kingbear79/VacUBear/pcb/3D_PCB1_2026-03-05.png

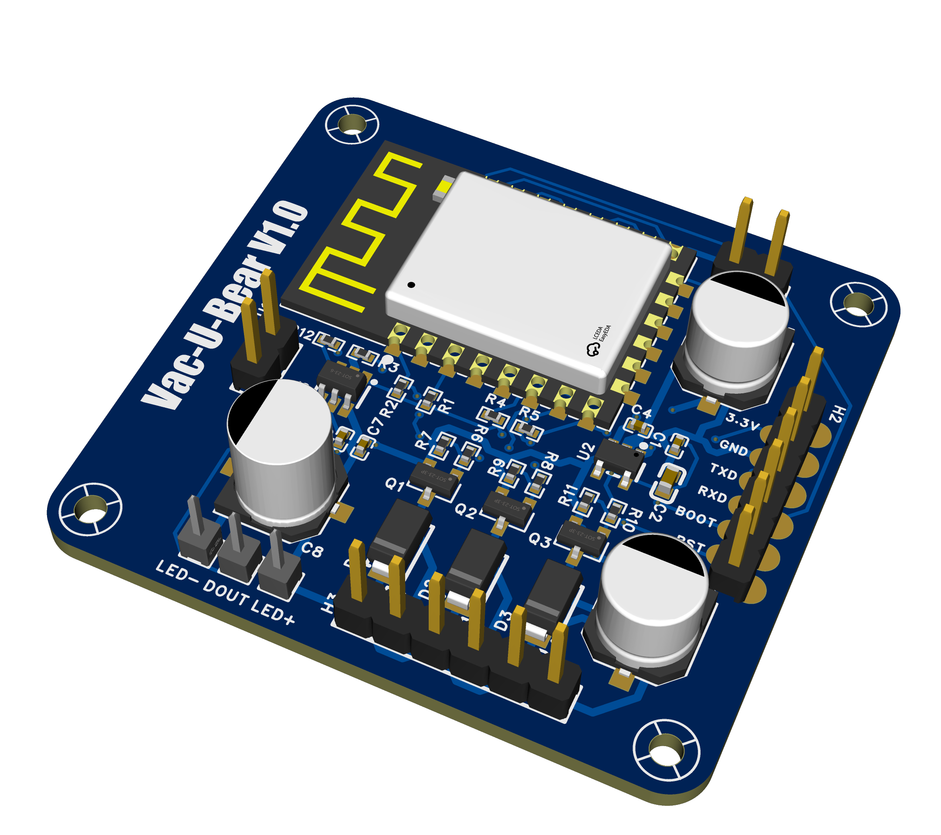
pcb/3D_PCB1_2026-03-05.png
