kingbear79/VacUBear/pcb/BOM_Board1_PCB1_2026-03-05.xlsx

No. | Quantity | Comment | Designator | Footprint | Value | Manufacturer Part | Manufacturer | Supplier Part | Supplier
1 | 4 | 100nF | C1,C4,C6,C7 | C0402 | 100nF | CL05B104KB54PNC | SAMSUNG(三星) | C307331 | LCSC
2 | 1 | 10uF | C2 | C0603 | 10uF | CL10A106MQ8NNNC | SAMSUNG(三星) | C1691 | LCSC
3 | 2 | 470uF | C3,C5 | CAP-SMD_BD6.3-L6.6-W6.6-LS7.6-RD | 470uF | RVT1C471M0607 | ROQANG(容强) | C2977552 | LCSC
4 | 1 | 100uF | C8 | CAP-SMD_BD6.3-L6.6-W6.6-LS7.2-FD | 100uF | RVT100UF16V67RV0016 | KNSCHA(科尼盛) | C2887276 | LCSC
5 | 3 | SS14 | D1,D2,D3 | SMA_L4.2-W2.6-LS5.0-RD_1 |  | SS14 | MDD(辰达半导体) | C2480 | LCSC
6 | 1 | POWER | H1 | HDR-TH_2P-P2.54-V-M-1
7 | 1 | PROG | H2 | PogoProgPad
8 | 1 | PUMPS | H3 | HDR-TH_6P-P2.54-V-M-1
9 | 1 | BTN | H4 | HDR-TH_2P-P2.54-V-M-1
10 | 1 | LED+ | H5 | HDR-TH_1P-V-M_XKB_X4611WV-01I-C28D40
11 | 1 | DOUT | H6 | HDR-TH_1P-V-M_XKB_X4611WV-01I-C28D40
12 | 1 | LED- | H7 | HDR-TH_1P-V-M_XKB_X4611WV-01I-C28D40
13 | 3 | AO3400A | Q1,Q2,Q3 | SOT-23-3_L2.9-W1.3-P1.90-LS2.4-BR |  | AO3400A | HUASHUO(华朔) | C700953 | LCSC
14 | 5 | 10kΩ | R1,R2,R3,R4,R5 | R0402 | 10kΩ | RC0402JR-0710KL | YAGEO(国巨) | C60489 | LCSC
15 | 3 | 100Ω | R6,R8,R10 | R0402 | 100Ω | FRC0402F1000TS | FOJAN(富捷) | C2906860 | LCSC
16 | 3 | 100kΩ | R7,R9,R11 | R0402 | 100kΩ | RC0402FR-07100KL | YAGEO(国巨) | C60491 | LCSC
17 | 1 | 33Ω | R12 | R0402 | 33Ω | FRC0402F33R0TS | FOJAN(富捷) | C2906868 | LCSC
18 | 1 | 330Ω | R13 | R0402 | 330Ω | FRC0402F3300TS | FOJAN(富捷) | C2930002 | LCSC
19 | 4 | Screw-Hole-M2 | SCREW1,SCREW2,SCREW3,SCREW4 | Screw-Hole-M2
20 | 1 | 2.4GHz | U1 | WIRELM-SMD_ESP-12F | 2.4GHz | ESP-12F | DOIT(四博智联) | C19949064 | LCSC
21 | 1 | TPAP2112K-3.3TRG1 | U2 | SOT-23-5_L2.9-W1.6-P0.95-LS2.8-BR |  | TPAP2112K-3.3TRG1 | TECH PUBLIC(台舟) | C3021085 | LCSC
22 | 1 | SN74LVC1T45DBVT | U3 | SOT-23-6_L2.9-W1.6-P0.95-LS2.8-BR |  | SN74LVC1T45DBVT | TI(德州仪器) | C116653 | LCSC
