kingbear79/VacUBear/pcb/SCH_Schematic1_2026-03-05.pdf

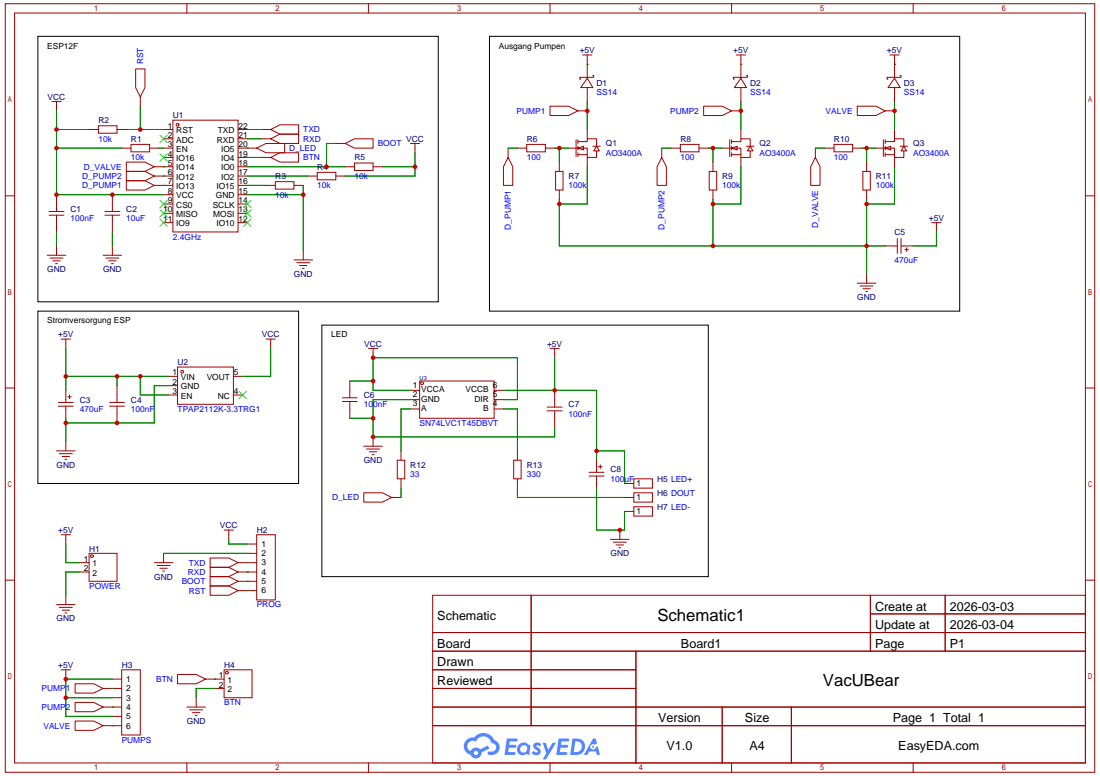
[picture p2: page 1]

Schematic | Schematic1 | Create at | 2026-03-03

Update at | 2026-03-04

Board | Board1 | Page | P1
Drawn | | VacUBear
Reviewed

Version | Size | Page 1 Total 1
V1.0 | A4 | EasyEDA.com
