kingbear79/VacUBear/pcb/PCB_PCB1_2026-03-05.pdf

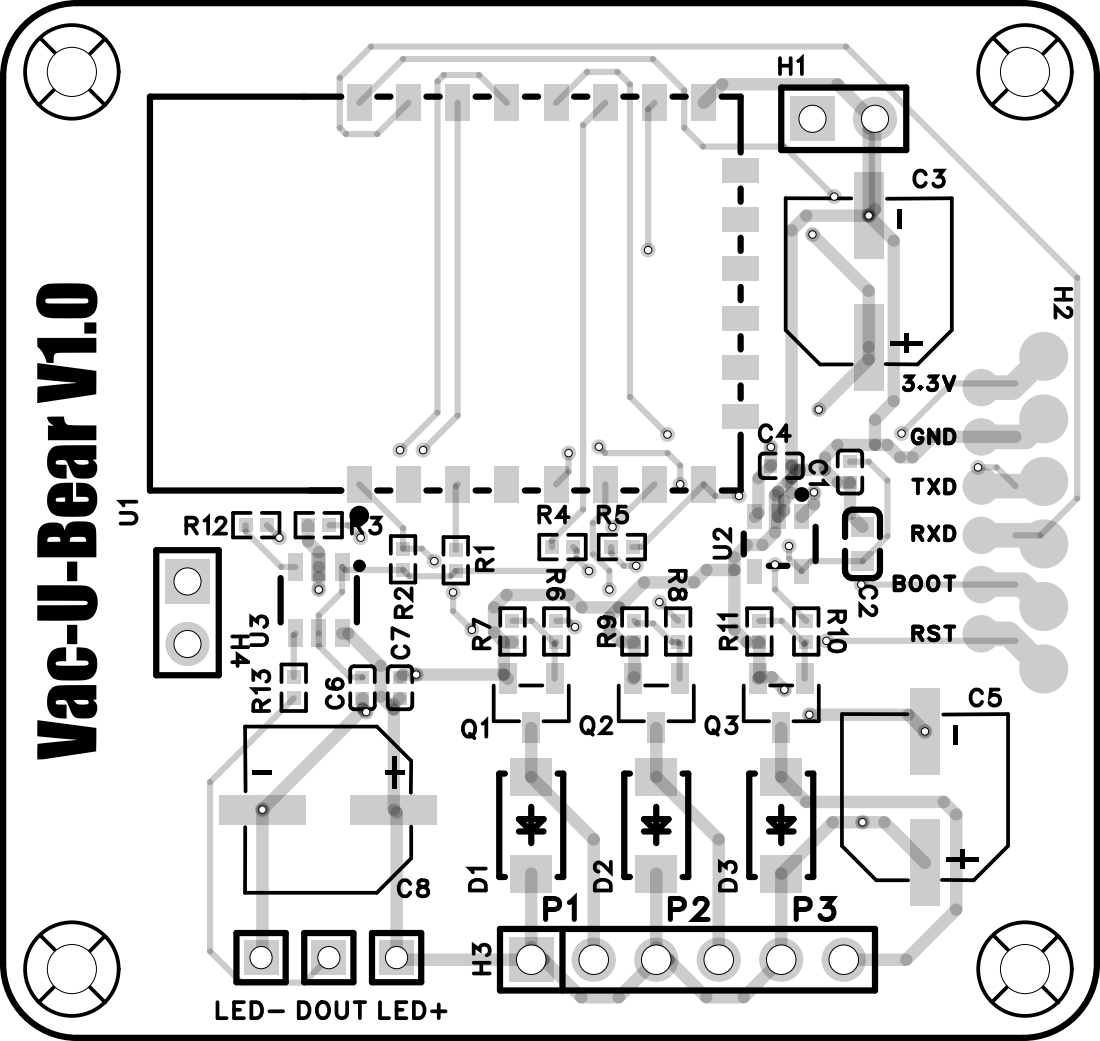
[picture p3: page 1]

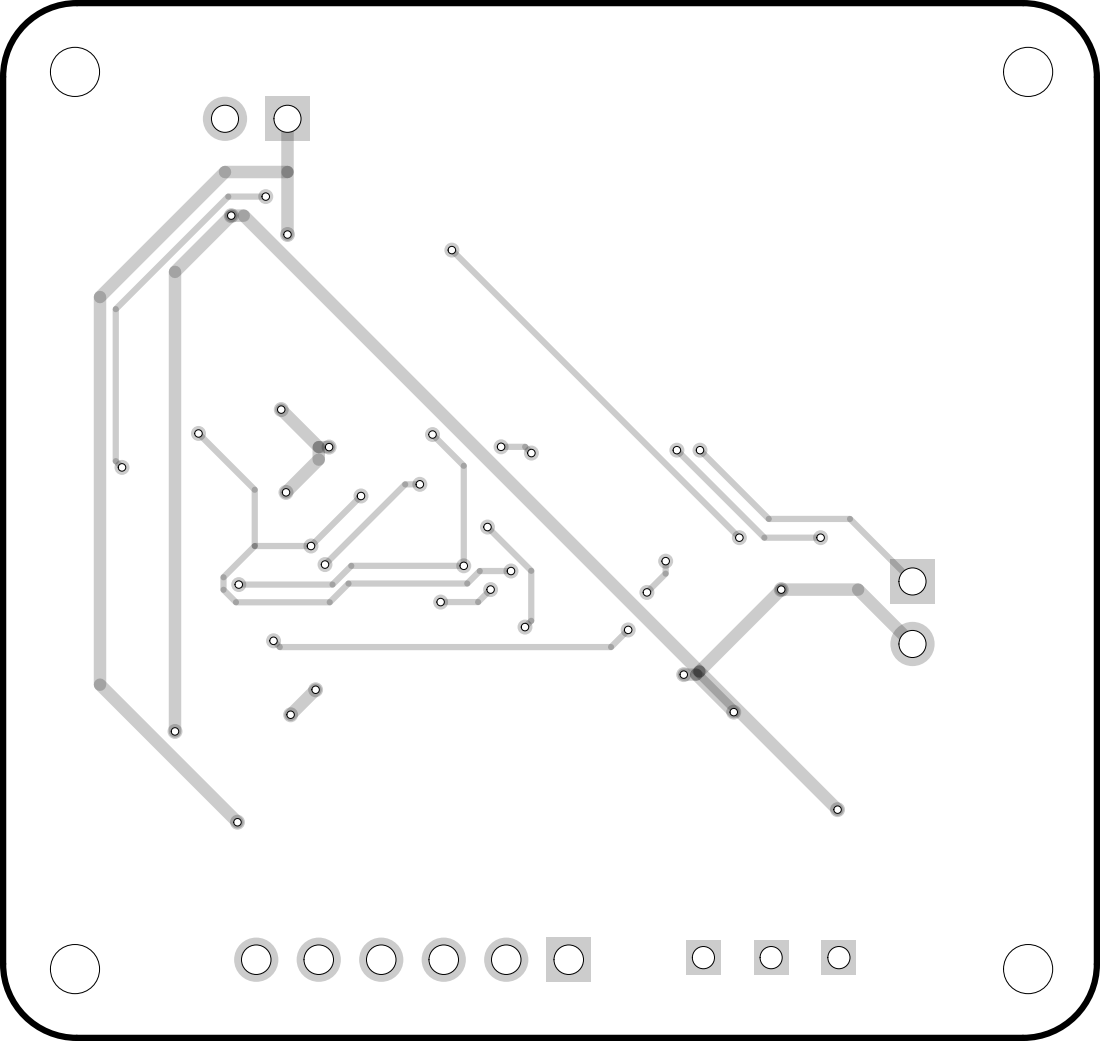
[picture p4: page 2]

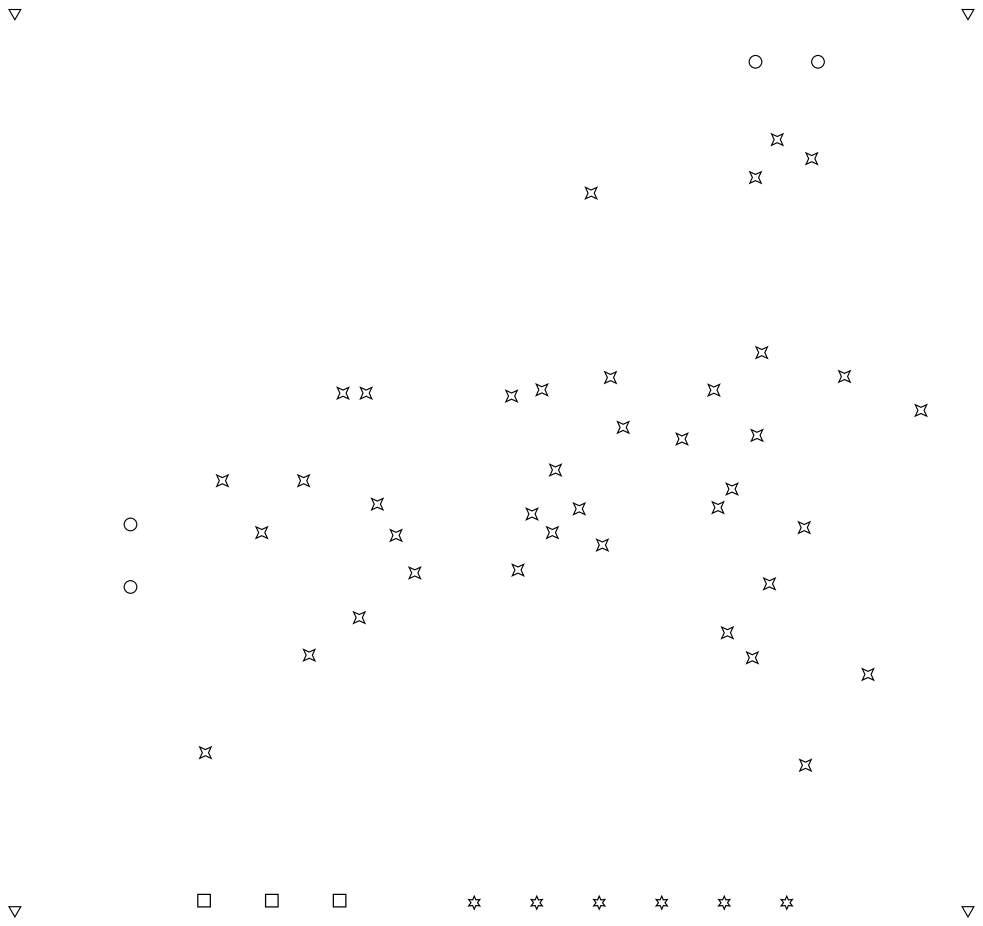
[picture p5: page 3]
