kingbear79/VacUBear/(list of files, drawings)

Other design files:
pcb/ProPrj_VacUBear_2026-03-05.epro
