kingbear79/VacUBear/(commit log)

2026-02-27 Add HA MQTT discovery, entity config, and unique device identity
2026-02-27 Add non-blocking pump soft-start and soft-stop control
2026-02-28 Switch OTA source to dist/ota/latest on master
2026-02-28 LEDs hinzugefügt
2026-02-28 Refactor readability, document architecture, and centralize pin config
2026-03-05 Added PCB Schematics and BOM
    [BOM_Board1_PCB1_2026-03-05.xlsx, ProPrj_VacUBear_2026-03-05.epro]
2026-03-05 Port to ESP-12F and document FT232RL wiring
2026-03-13 Add HA firmware update entity and faster boot flow
2026-03-13 Modernize ArduinoJson usage
2026-03-13 Switch OTA to local HTTP hosting
2026-03-14 Reduce OTA status polling pressure
2026-03-14 Add button long-press actions
2026-03-14 Stabilize button light toggle timing
    [main.cpp]
2026-03-15 Handle captive portal probe endpoints
2026-03-22 Updated LED count
2026-03-23 Guard show start on boot and tighten LED timing
    [main.cpp]
2026-03-23 Harden startup and LED output timing
2026-03-24 Use pin-safe SK6812 no-interrupt LED driver
2026-03-24 Replace NeoPixelBus with minimal SK6812 driver
    [main.cpp]
2026-03-24 Stage show actuators after LED fades
2026-03-24 Publish OTA landing page assets
